poommyroboticcamera-netizen/ESC-FOC-Drive-V02/hardware/CURRENT_SENSE_ERRATUM_TH.md

# ข้อแก้ไขวงจรวัดกระแส ESC V02: C39 / C42 / C45

**สถานะ: พบความเสี่ยงในฮาร์ดแวร์จริง; ยังไม่ได้ยืนยันผลหลังแก้บอร์ด**

ใน [schematic วันที่ 2026-09-22 หน้า 4](SCH_drive_2026-09-22.pdf) C39, C42 และ C45 ต่อ **100 nF โดยตรง** จากขา OUT ของ INA181A1 U13/U14/U15 ลง AGND ตามลำดับ [BOM](BOM_BLDCv02.xlsx) ก็ระบุทั้งสามตัวเป็น 100 nF และผู้ใช้ยืนยันว่าบอร์ดที่ทดสอบใส่ครบ TI ระบุใน [INA181 datasheet หัวข้อ Electrical Characteristics](https://www.ti.com/lit/ds/symlink/ina181.pdf) ว่า capacitive load สูงสุดสำหรับเงื่อนไข “no sustained oscillation” คือ **1 nF** การต่อ 100 nF จึงเกินสเปกนี้ 100 เท่าและเป็นสาเหตุที่เป็นไปได้สูงของการสั่นที่เอาต์พุตเซนเซอร์

หลักฐานจาก `CZERO` บนบอร์ดนี้: trimmed spread ของ U/V/W เท่ากับ **1011 / 925 / 1057 ADC counts** ใน 64 scans ขณะมอเตอร์หยุด เทียบกับเกณฑ์ 48 counts ของเฟิร์มแวร์ v34 โปรแกรมปฏิเสธการสอบศูนย์ถูกต้องแล้ว ข้อมูลนี้ยังไม่พิสูจน์ด้วยออสซิลโลสโคปว่าขา OUT สั่น จึงต้องทดสอบหลังแก้ฮาร์ดแวร์

## แก้บนบอร์ดที่ประกอบแล้ว

1. หยุดมอเตอร์ ตัด VSUPPLY, USB และ ST-LINK รอและ **วัดให้แน่ใจ** ว่าคาปาซิเตอร์ภาคกำลังคายประจุแล้ว ก่อนแตะ PCB
2. ถอด **C39, C42, C45** ออกจากบอร์ดและปล่อยตำแหน่งนี้ว่างเพื่อทดสอบ อย่าถอด C38/C41/C44 ซึ่งเป็น bypass ที่ขา VS ของ INA181 และอย่าสับสนกับ C37/C40/C43 ที่คร่อมชันต์
3. ตรวจด้วยแว่นขยายว่า pad ทั้งสองของแต่ละตำแหน่งไม่ช็อตและลาย CURRENT_U/V/W ไม่เสียหาย [PCB drawing](PCB_V02_2026-09-22.pdf) ระบุ C39 อยู่ข้าง U13, C42 ข้าง U14, C45 ข้าง U15
4. ต่อไฟเลี้ยงแบบจำกัดกระแสตามบอร์ดโดย **ยังไม่ต่อมอเตอร์** ตรวจว่าราง 3.3 V และ REF ของทั้งสามแอมป์อยู่ใกล้ 1.65 V จากนั้นสั่ง `CSCAN ON` และ `CZERO` อีกครั้ง
5. คาดว่าเอาต์พุตที่ไม่มีกระแสจะอยู่ใกล้ REF (ประมาณ 2048 ADC counts ถ้า VDDA=3.3 V) และ `CZERO` ต้องตอบ `OK CZERO state=READY` หากยังไม่ผ่าน ให้จับรูปคลื่น OUT/REF/3.3 V ทีละช่องด้วยโพรบที่อ้าง AGND และตรวจการเดินสาย/ไฟเลี้ยง/ค่า ADC ก่อนขับมอเตอร์ อย่าขยายเกณฑ์ 48 counts เพื่อให้ผ่าน

การถอดคาปาซิเตอร์เป็น **การวินิจฉัยและแก้ภาระโหลดที่เกินสเปก** ไม่ได้ยืนยันว่าการวัดกระแสระหว่าง PWM ถูกต้อง หลัง zero ผ่าน ยังต้องตรวจรูปคลื่น OUT ที่ PWM, จุดเวลาสุ่มตัวอย่าง, polarity และเทียบแอมป์กับกระแสอ้างอิงก่อนใช้งานจริง หากต้องการกรองความถี่สูงใน PCB revision ถัดไป ให้ออกแบบ filter ที่มีการแยกโหลด capacitive จากขา OUT แล้วตรวจเสถียรภาพตาม datasheet; อย่าคัดลอก 100 nF ต่อ OUT โดยตรง
