poommyroboticcamera-netizen/ESC-FOC-Drive-V02/hardware/BOM_BLDCv02.xlsx

No. | Quantity | Comment | Designator | Footprint | Value | Manufacturer Part
1 | 3 | 2.2uF | C18,C19,C20 | C0805 | 2.2uF | CL21A225KBQNNNE
2 | 6 | 22nF | C25,C26,C27,C28,C29,C30 | C1206 | 22nF | HHV1206R7223K631NSPJ
3 | 6 | 10uF | C31,C32,C33,C34,C35,C36 | C0805 | 10uF | GRM21BR61H106KE43L
4 | 12 | 100nF | C37,C38,C39,C40,C41,C42,C43,C44,C45,C58,C82,C83 | C0805 | 100nF | C0805X104K5RAC3123
5 | 4 | 1uF | C46,C47,C48,C50 | C0805 | 1uF | FS21X105K160ECG
6 | 1 | 2.2uF | C49 | C0805 | 2.2uF | FS21X105K160ECG
7 | 2 | 100nF | C59,C61 | C1206 | 100nF | CL31B104KBCNNNC
8 | 3 | 2.2uF | C60,C62,C76 | C1206 | 2.2uF | CL31B225KBHNNNE
9 | 2 | 4.7uF | C64,C66 | C0805 | 4.7uF | CL21A475KAQNNNE
10 | 2 | 22nF | C65,C68 | C0805 | 22nF | CL21B223KBANNNC
11 | 1 | 1uF | C72 | C0805 | 1uF | CL21B105KBFNNNE
12 | 3 | 22uF | C73,C74,C75 | C0805 | 22uF | CL21A226MAQNNNE
13 | 2 | 18pF | C77,C78 | C0603 | 18pF | C1608NP0180JGTS
14 | 2 | 2.2uF | C79,C80 | C0805 | 2.2uF | CL21B225KOFNNNE
15 | 1 | 10nF | C81 | C0805 | 10nF | C2012X7R2E103K125AA
16 | 3 | FR107 | D4,D5,D6 | SMA_L4.2-W2.7-LS5.3-FD |  | FR107
17 | 1 | SS510B | D7 | SMB_L4.3-W3.6-LS5.3-RD |  | SS510B
18 | 1 | SMF12A | D8 | SOD-123_L2.8-W1.8-LS3.7-RD |  | SMF12A
19 | 1 | SMF5.0A | D10 | SOD-123_L2.8-W1.8-LS3.7-RD |  | SMF5.0A
20 | 1 | SMF3.3A | D11 | SOD-123_L2.8-W1.8-LS3.7-RD |  | SMF3.3A
21 | 1 | XY-PZ2.54V-01-10P | H2 | HDR-TH_10P-P2.54-V-M_4 |  | XY-PZ2.54V-01-10P
22 | 2 | 2.54-1*3P | H3,H4 | HDR-TH_3P-P2.54-V-M-1 |  | 2.54-1*3P
23 | 1 | 68uH | L2 | IND-SMD_L7.8-W7.0_SCD0705N | 68uH | SM7850-680M(f)
24 | 1 | KT-0805Y | LED1 | LED0805-R-RD |  | KT-0805Y
25 | 6 | IRFS7530TRL7PP | Q1,Q2,Q3,Q4,Q5,Q6 | D2PAK-7_L10.6-W9.6-P1.27-LS15.9-BR |  | IRFS7530TRL7PP
26 | 3 | EG3112D | R20,R39,R40 | SOP-8_L5.0-W3.9-P1.27-LS6.0-BL-1 |  | EG3112D
27 | 3 | 56K | R32,R59,R60 | R0805_NEW | 56K | RK73H1JTTD10R0F
28 | 6 | 10Ω | R41,R42,R43,R44,R45,R46 | R0603 | 10Ω | WF06P10R0FTL
29 | 3 | 1mΩ | R47,R50,R53 | R2512 | 1mΩ | HIXD25LR001F
30 | 6 | 1kΩ | R48,R49,R51,R52,R54,R55 | R0805 | 1kΩ | AS05W3J0102T5E
31 | 3 | 2.2kΩ | R56,R57,R58 | R0805 | 2.2kΩ | RK73B2ATTD222J
32 | 5 | 10kΩ | R61,R85,R86,R88,R89 | R0805 | 10kΩ | AS05W3J0102T5E
33 | 1 | 30kΩ | R63 | R0603 | 30kΩ | RMC060330K5%N
34 | 1 | 274kΩ | R64 | R0805 | 274kΩ | WR08X2743FTL
35 | 4 | 10kΩ | R65,R66,R69,R70 | R0603 | 10kΩ | KTR03EZPJ103
36 | 1 | 45.3kΩ | R71 | R0603 | 45.3kΩ | WR06X4532FTL
37 | 1 | 5.1kΩ | R72 | R1206 | 5.1kΩ | RK73B2BTTD512J
38 | 9 | 0Ω | R73,R74,R75,R76,R77,R78,R79,R80,R81 | R1206 | 0Ω | 1206W4F0000T5E
39 | 1 | 4.3kΩ | R82 | R0603 | 4.3kΩ | RTT034301FTP
40 | 1 | 73.2kΩ | R83 | R0603 | 73.2kΩ | TD03G7322BT
41 | 1 | 120Ω | R84 | R0805 | 120Ω | CRGCQ0805F120R
42 | 2 | 1kΩ | R87,R90 | R0805 | 1kΩ | TP0805B1K00P0510Z
43 | 4 | TS-1088-AR02016 | SW1,SW2,SW3,SW4 | SW-SMD_L3.9-W3.0-P4.45 |  | TS-1088-AR02016
44 | 2 | 1935174 | U12,U20 | CONN-TH_3P-P5.00_1935174 |  | 1935174
45 | 3 | INA181A1IDBVR | U13,U14,U15 | SOT-23-6_L2.9-W1.6-P0.95-LS2.8-TL |  | INA181A1IDBVR
46 | 1 | STM32F405RGT6 | U18 | LQFP-64_L10.0-W10.0-P0.50-LS12.0-BL |  | STM32F405RGT6
47 | 3 | xh2.54-4p | U19,U27,U28 | CONN-TH_4P-P2.50-XH2.54-4P |  | xh2.54-4p
48 | 1 | SCT2A23STER | U21 | ESOP-8_L4.9-W3.9-P1.27-LS6.0-BL-EP-1 |  | SCT2A23STER
49 | 1 | 68pF | U22 | C0805 | 68pF | HGC0805G0680J500NTGJ
50 | 2 | RY8120 | U23,U25 | SOT-23-6_L2.9-W1.6-P0.95-LS2.8-BL |  | RY8120
51 | 2 | 2.2uH | U24,U26 | IND-SMD_L2.5-W2.0-VLS252012CX-150M |  | 2.2uH
52 | 1 | MCP2551-I/SN | U29 | SOIC-8_L4.9-W3.9-P1.27-LS6.0-BL |  | MCP2551-I/SN
53 | 1 | 8MHz | X4 | CRYSTAL-SMD_4P-L3.2-W2.5-BL | 8MHz | X32258MOB4SI
