poommyroboticcamera-netizen/ESC-FOC-Drive-V02/vesc_firmware_custom/CALIBRATION_2026-09-07_TH.md

# ผลตั้งศูนย์กระแส INA181 วันที่ 7 กันยายน 2026

คาลิเบรตด้วยวงจรที่ผู้ใช้ต่ออยู่ โดยรีเซ็ต MCU ให้ firmware v5 เรียก `do_dc_cal()` ใหม่ ขณะบอร์ด DISARMED ผู้ใช้ยืนยันในบริบทการทดสอบว่าถอดมอเตอร์และปิด PWM อยู่ ไม่มีการส่งคำสั่ง ARM หรือขับมอเตอร์ในรอบนี้ และไม่ได้แฟลชเฟิร์มแวร์ใหม่

## หลักฐานเฟิร์มแวร์และค่า offset

- บอร์ด USB COM7, MCU device ID 0x413; ST-LINK รายงานแรงดันเป้าหมาย 3.25 V
- อ่าน flash กลับและเทียบกับ `bldc_lite_24_sensorless_sixstep_v5_no_startup_boost_raw_oc_2026-09-03.bin`: พื้นที่ 0x08000000–0x08003FFF และ 0x0800C000–0x0807FFEF ตรงกันทุกไบต์ โดยไม่รวม EEPROM และ CRC ที่เปลี่ยนระหว่างทำงาน
- คาลิเบรตเดิมของ v5 รอ 1 วินาที แล้วเฉลี่ยอย่างน้อย 4,000 ตัวอย่างแยกเฟส
- อ่านค่าจริงใน RAM ผ่าน ST-LINK Hot Plug โดยใช้อ้างอิง symbol จาก ELF v5 ที่ตรงกับโค้ดบนบอร์ด

| เฟส | Offset ก่อน (ADC counts) | Offset หลัง (ADC counts) |
|---|---:|---:|
| U | 2052 | 2050 |
| V | 2052 | 2049 |
| W | 2046 | 2043 |

หลังรีเซ็ต `dccal_done = 1`, `software_armed = 0` และ USB รายงาน `Current DC calibration: DONE`, `Software interlock: DISARMED`

## ผลตรวจหลังหัก offset

ใช้ `tools/measure_bldc_zero_usb.ps1` เก็บ COMM_SAMPLE_PRINT / DEBUG_SAMPLING_NOW แบบ raw 3 รอบ รอบละ 512 ตัวอย่าง decimation 20 รวม 1,536 ตัวอย่างต่อเฟส ตรวจ CRC และจำนวน sample index ครบทุกรอบ ข้อมูลนี้มาจาก `ADC_curr_raw` หลังหัก offset ในเส้นทาง BLDC ไม่ใช่ค่า JDR ที่ยังไม่ผ่านตัวกรอง median

ใช้สเกลตาม v5: `(3.3 / 4095) / (0.001 × 20) = 0.040293 A/count` เครื่องหมายในตารางเป็นเครื่องหมาย ADC หลังหัก offset ก่อนเลือกเครื่องหมายของกระแสรวม BLDC

| เฟส | ค่าเฉลี่ย (A) | ค่าต่ำสุด (A) | ค่าสูงสุด (A) | ส่วนเบี่ยงเบนมาตรฐาน (A) |
|---|---:|---:|---:|---:|
| U | -0.03345 | -0.68498 | +0.76557 | 0.12437 |
| V | -0.01495 | -0.64469 | +0.80586 | 0.12592 |
| W | -0.02809 | -0.56410 | +0.84615 | 0.12184 |

ค่าเฉลี่ยอยู่ห่างศูนย์ไม่เกิน 1 ADC count ทุกเฟส แต่ยังพบความแกว่งประมาณ 1.41–1.45 A peak-to-peak ในหน้าต่างที่เก็บมา การตั้งศูนย์จึงเสร็จแล้ว แต่ผลนี้ยังไม่ยืนยันความพร้อมควบคุมกระแส 0.05 A หรือแก้ ABS_OVER_CURRENT ขณะขับมอเตอร์

ค่า offset อยู่ใน RAM และเฟิร์มแวร์จะคาลิเบรตใหม่เมื่อบูต ไม่ใช่การสอบเทียบ gain ด้วยแหล่งกระแสอ้างอิง ค่าบัส 24 V เป็น nominal/estimate ของเฟิร์มแวร์ ไม่ใช่หลักฐานการวัดแรงดันแหล่งจ่ายจริง

ขั้นวิเคราะห์ต่อไปคือวัด OUT, REF และไฟเลี้ยงเทียบกับกราวด์ที่เกี่ยวข้อง ขณะอยู่เงื่อนไขเดียวกับการเก็บ ADC เพื่อแยก noise อนาล็อกออกจากผลของการเก็บตัวอย่าง/กราวด์ สถานะสุดท้ายคง DISARMED และขีดจำกัด fault เดิม
