poommyroboticcamera-netizen/ESC-FOC-Drive-V02/vesc_firmware_custom/tests/overvoltage_fault/overvoltage_test_v2.pdf

Over Voltage Protection Test | Test Results
PSU Normal (Old) | PSU Worst (Old) | PSU Normal (New) | PSU Worst (New)
25.93 V | 32.66 V | 25.43 V | 26.55 V
25.84 V | 32.99 V | 25.44 V | 26.82 V
25.85 V | 33.25 V | 25.64 V | 26.94 V
25.91 V | 33.34 V | 25.46 V | 27.13 V
25.84 V | 33.19 V | 25.72 V | 26.73 V
26.00 V | 33.23 V | 25.63 V | 26.70 V

Test Conditions
Hardware | VESC 6 MK5
Motor | Trampa 160 KV Outrunner
PSU Voltage | 20 V
Max voltage limit | 25 V
Motor Current | 60 A
FOC PI Time Constant | 200 µS

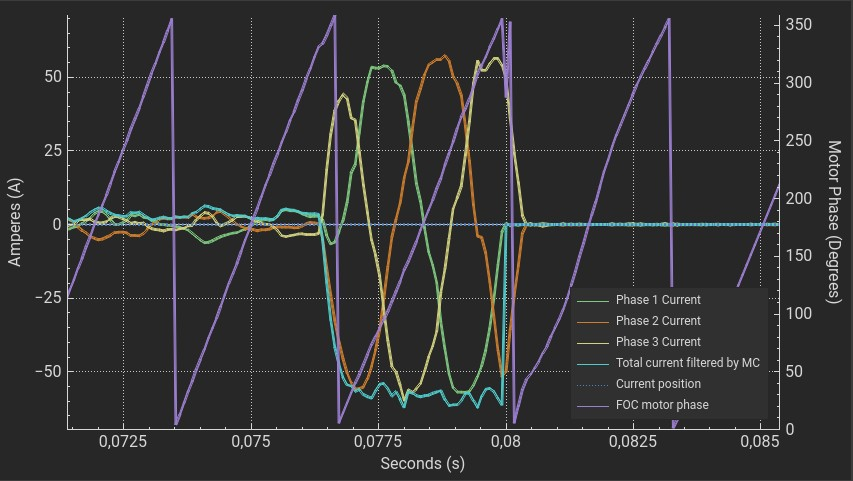
[picture p7: figure]
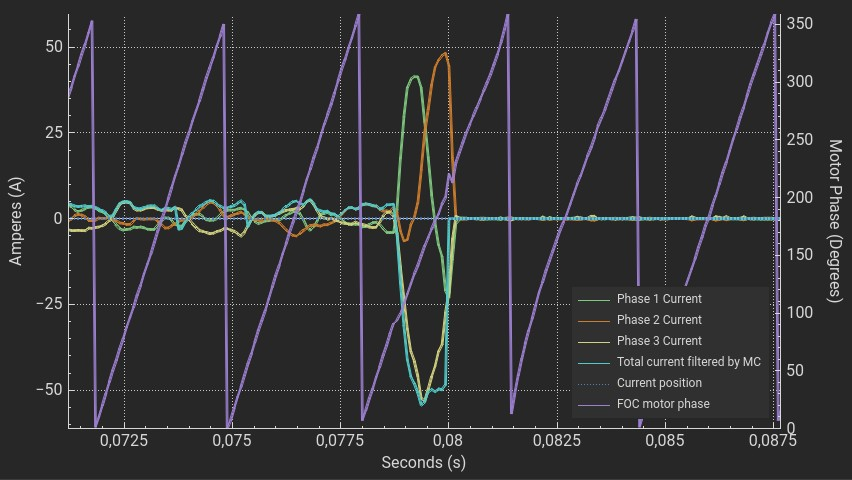
[picture p8: figure]

Old Current plot on normal PSU | Old Current plot on worst PSU

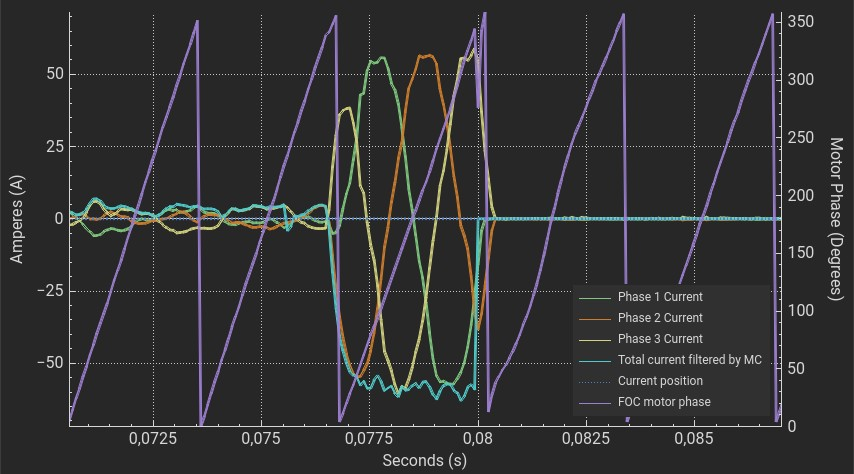
[picture p9: figure]
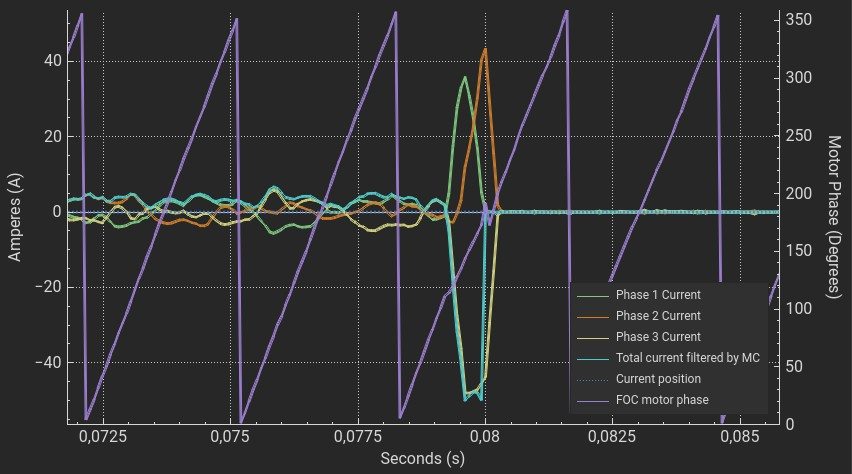
[picture p10: figure]

New Current plot on normal PSU | New Current plot on worst PSU

Run motor at full speed and apply full reverse (that ramps the current faster than full brake). The current controller time constant is set very low so that the current rises fast. Print faults in terminal and write down at which voltage they triggered. PSU normal is a 30V 30A PSU and PSU worst is a 30V 5A PSU that sinks almost no current, so we mostly rely on the capacitance in the VESC to prevent the voltage from rising too much.

Old is the 8-cycle implementation and new is the improved one. The new implementation is also tested on a VESC 6 with a fully charged 12S battery on a scooter to make sure that is doesn’t trigger too easily.
