poommyroboticcamera-netizen/ESC-FOC-Drive-V02/arduino_sixstep_releases/RELEASE_NOTES_current_v1.md

# Arduino six-step current v1

ไฟล์ใน Release นี้สำหรับ STM32F405RGT6:

- `stm32f405-sixstep-current-v1.zip` — ซอร์สโค้ด
- `stm32f405-sixstep-current-v1.elf` — ELF พร้อมแฟลชผ่าน ST-LINK/SWD

SHA-256: `41c9ef685e92431f3b0fc208826f3bf9d339aa6511d98fcc7d4af30b0b86b997`

ELF SHA-256: `28bdb8773c9fb3394c69be11bac83fe93891aadef9d08aa79ec0d24f5e562b32`

รุ่น bring-up ผ่าน Serial Monitor ใช้ INA181 บน PC0/PC1/PC2, zero calibration และ software current trip **ไม่รองรับ SAT motor pilot** และ software trip ไม่ทดแทนวงจร hardware over-current shutdown

วิธีแฟลชและใช้งาน: [คู่มือ Arduino six-step](https://github.com/poommyroboticcamera-netizen/ESC-FOC-Drive-V02/blob/main/arduino_sixstep_releases/README_TH.md)

วิธีแฟลช ELF: [คู่มือ ST-LINK/SWD](https://github.com/poommyroboticcamera-netizen/ESC-FOC-Drive-V02/blob/main/arduino_sixstep_releases/ELF_FLASH_GUIDE_TH.md) สร้างด้วย STM32duino 3.0.0; Verify ผ่าน แต่ยังไม่ได้ทดสอบกับบอร์ดจริง

> ค่ากระแสต้องสอบเทียบกับวงจรจริงก่อนเชื่อผล รุ่นนี้ยังไม่ผ่านการรับรองกับภาคกำลังจริง ใช้แหล่งจ่ายจำกัดกระแส ฟิวส์ และสวิตช์ตัด DC bus
