poommyroboticcamera-netizen/ESC-FOC-Drive-V02/hardware/SCH_drive_2026-09-22.pdf

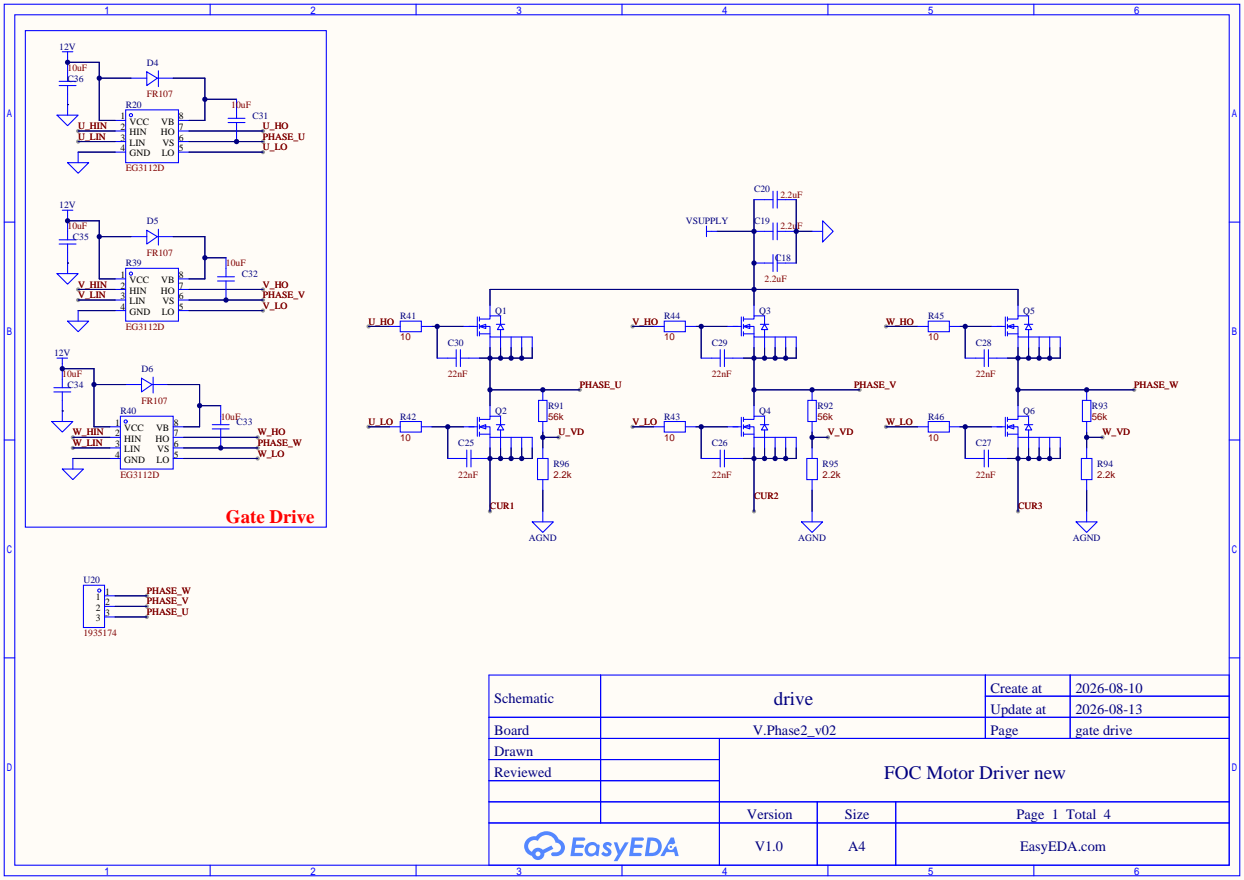
[picture p58: page 1]

Schematic | drive | Create at | 2026-08-10

Update at | 2026-08-13

Board | V.Phase2_v02 | Page | gate drive
Drawn | | FOC Motor Driver new
Reviewed

Version | Size | Page 1 Total 4

V1.0 | A4 | EasyEDA.com

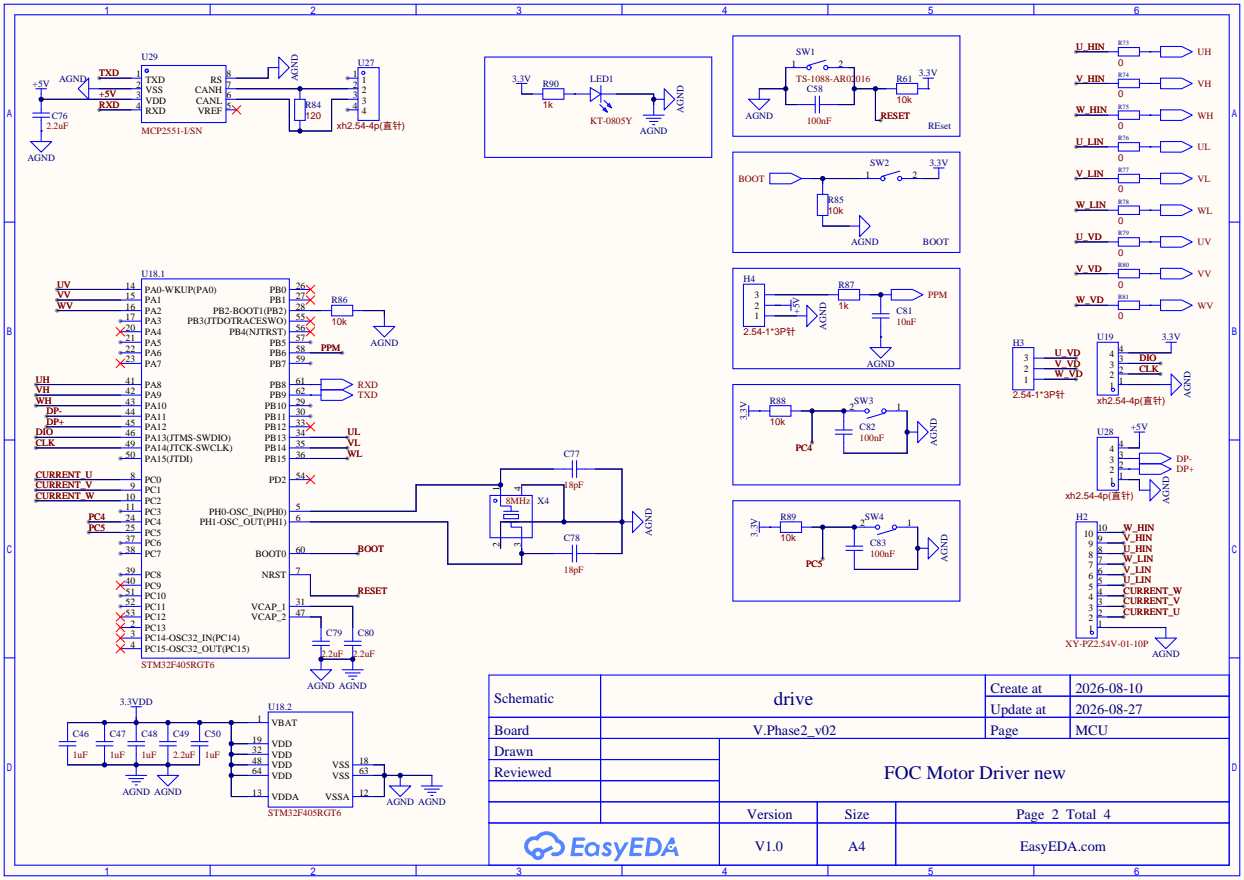
[picture p59: page 2]

Schematic | drive | Create at | 2026-08-10

Update at | 2026-08-27

Board | V.Phase2_v02 | Page | MCU
Drawn | | FOC Motor Driver new
Reviewed

VDD 19

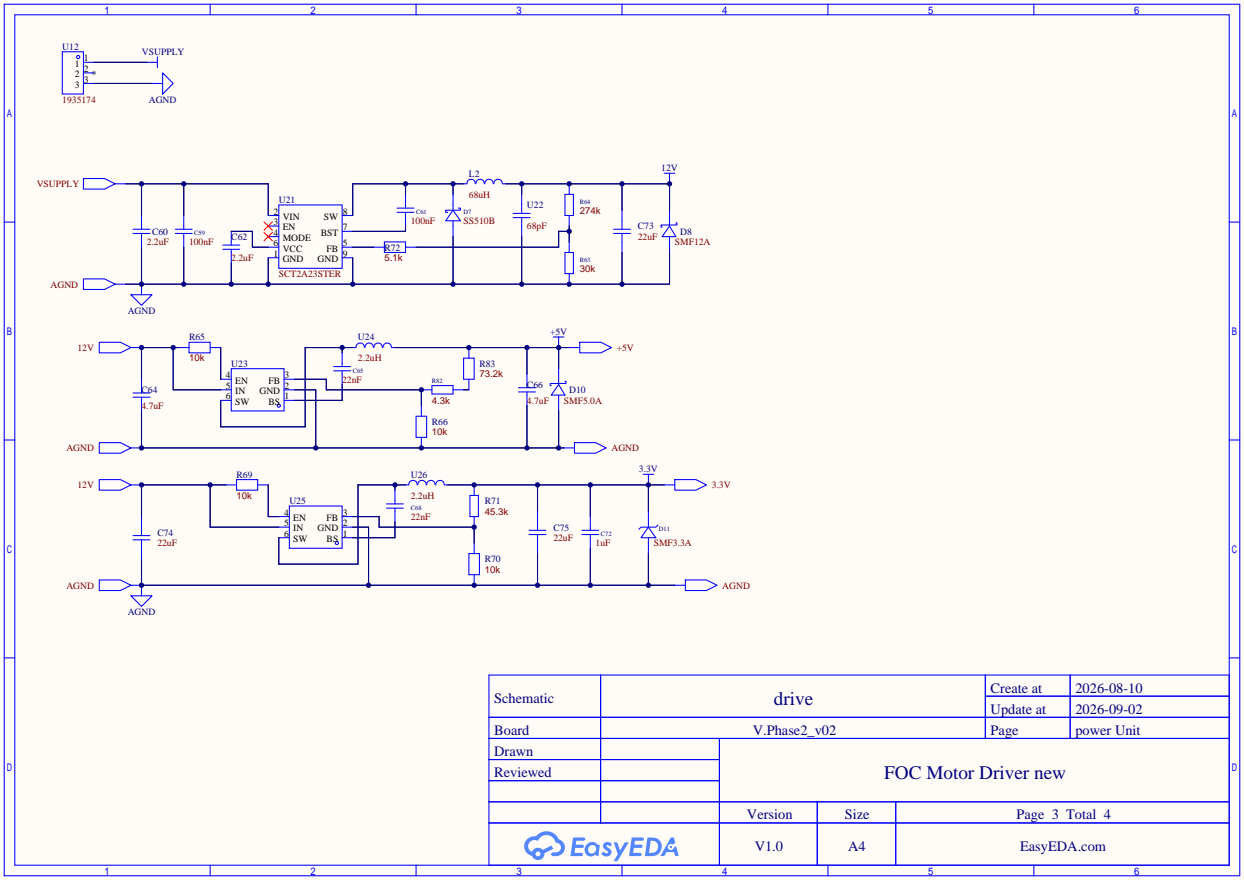
[picture p60: page 3]

Schematic | drive | Create at | 2026-08-10

Update at | 2026-09-02

Board | V.Phase2_v02 | Page | power Unit
Drawn | | FOC Motor Driver new
Reviewed

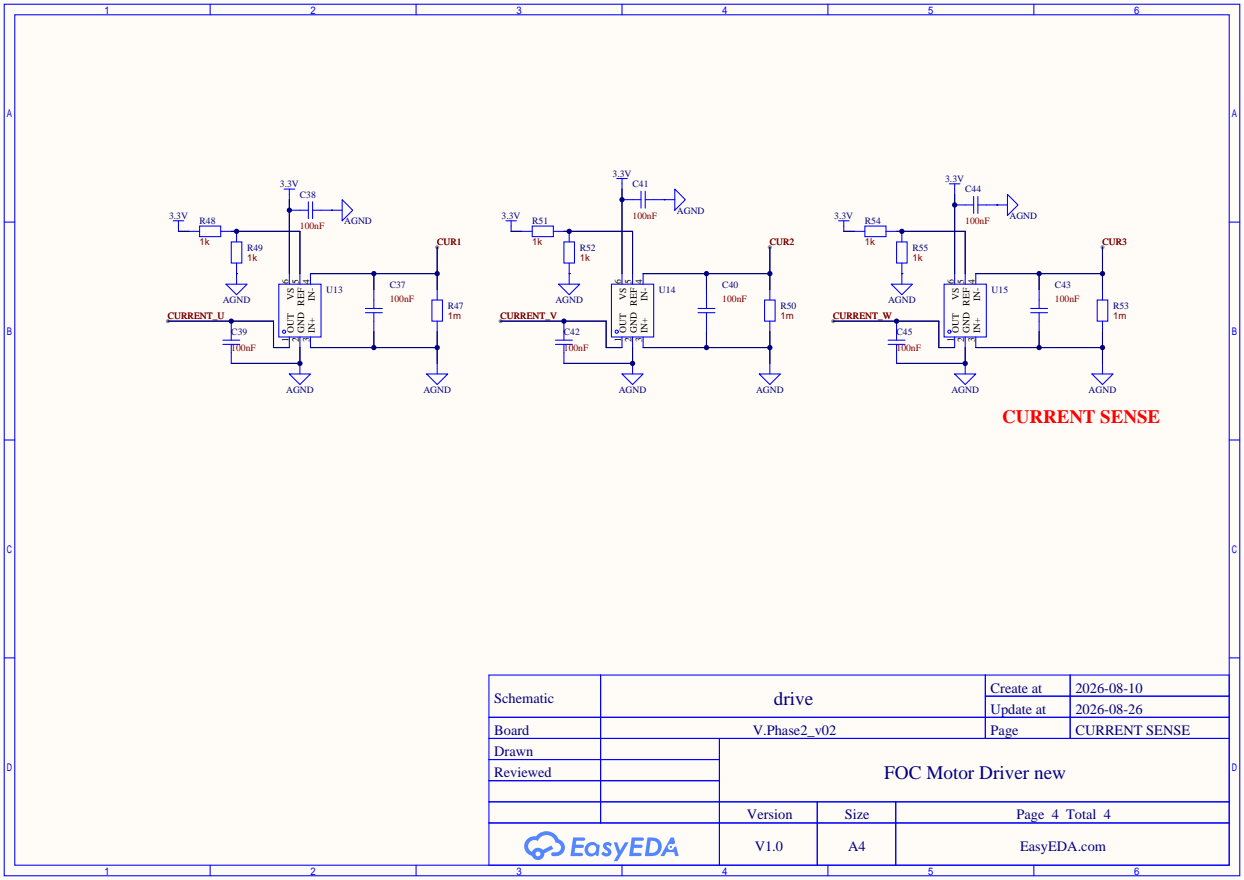
[picture p61: page 4]

Schematic | drive | Create at | 2026-08-10

Update at | 2026-08-26

Board | V.Phase2_v02 | Page | CURRENT SENSE
Drawn | | FOC Motor Driver new
Reviewed
