poommyroboticcamera-netizen/ESC-FOC-Drive-V02/hardware/SCH_v2_2026-08-01.pdf

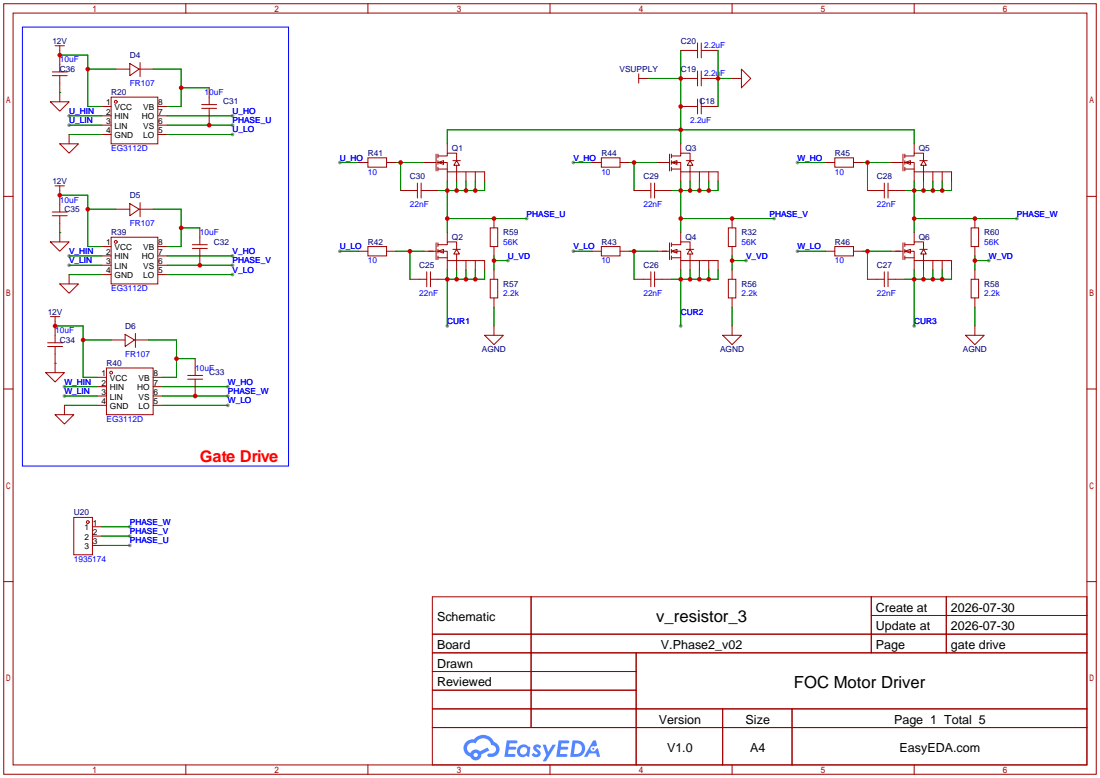
[picture p62: page 1]

Schematic | v_resistor_3 | Create at | 2026-07-30

Update at | 2026-07-30

Board | V.Phase2_v02 | Page | gate drive
Drawn | | FOC Motor Driver
Reviewed

Version | Size | Page 1 Total 5
V1.0 | A4 | EasyEDA.com

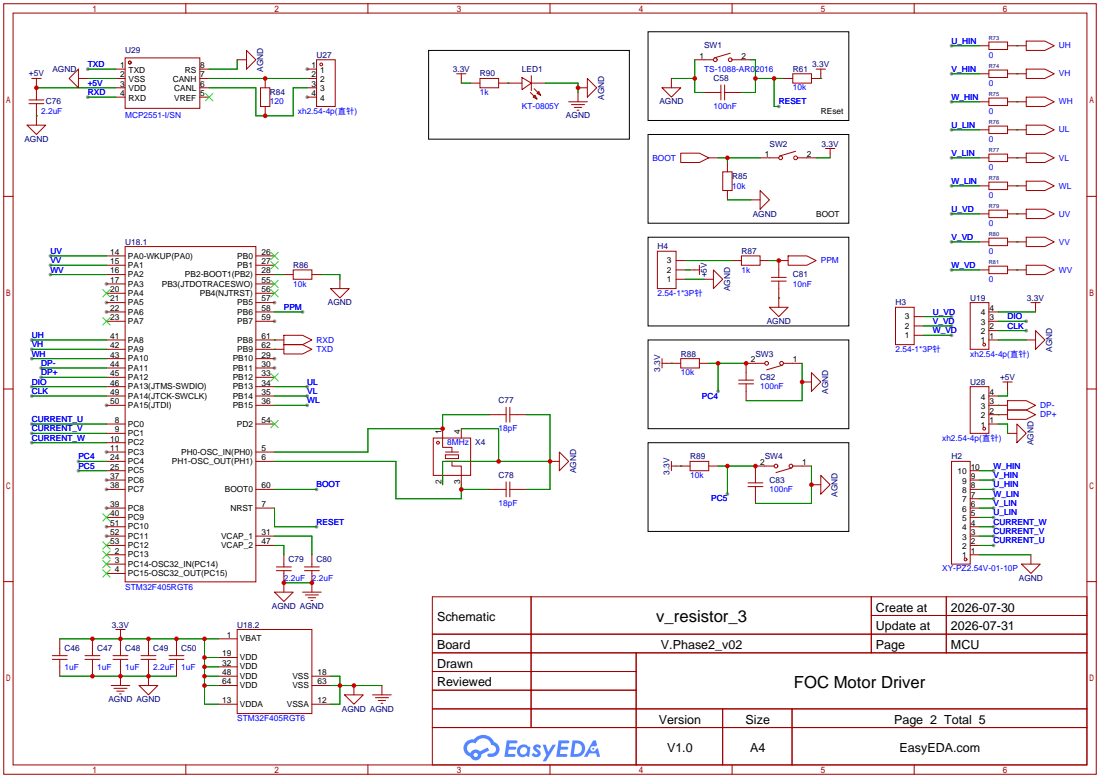
[picture p63: page 2]

Schematic | v_resistor_3 | Create at | 2026-07-30

Update at | 2026-07-31

Board | V.Phase2_v02 | Page | MCU
Drawn | | FOC Motor Driver
Reviewed

VDD 19

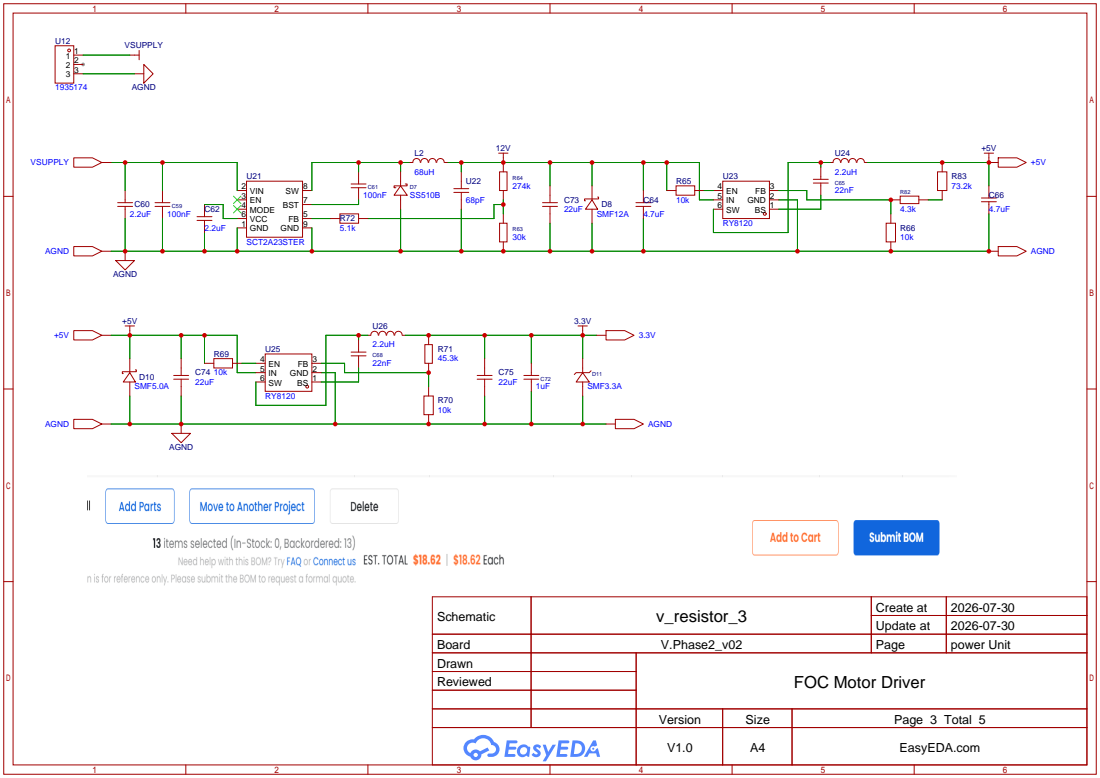
[picture p64: page 3]

Schematic | v_resistor_3 | Create at | 2026-07-30

Update at | 2026-07-30

Board | V.Phase2_v02 | Page | power Unit
Drawn | | FOC Motor Driver
Reviewed

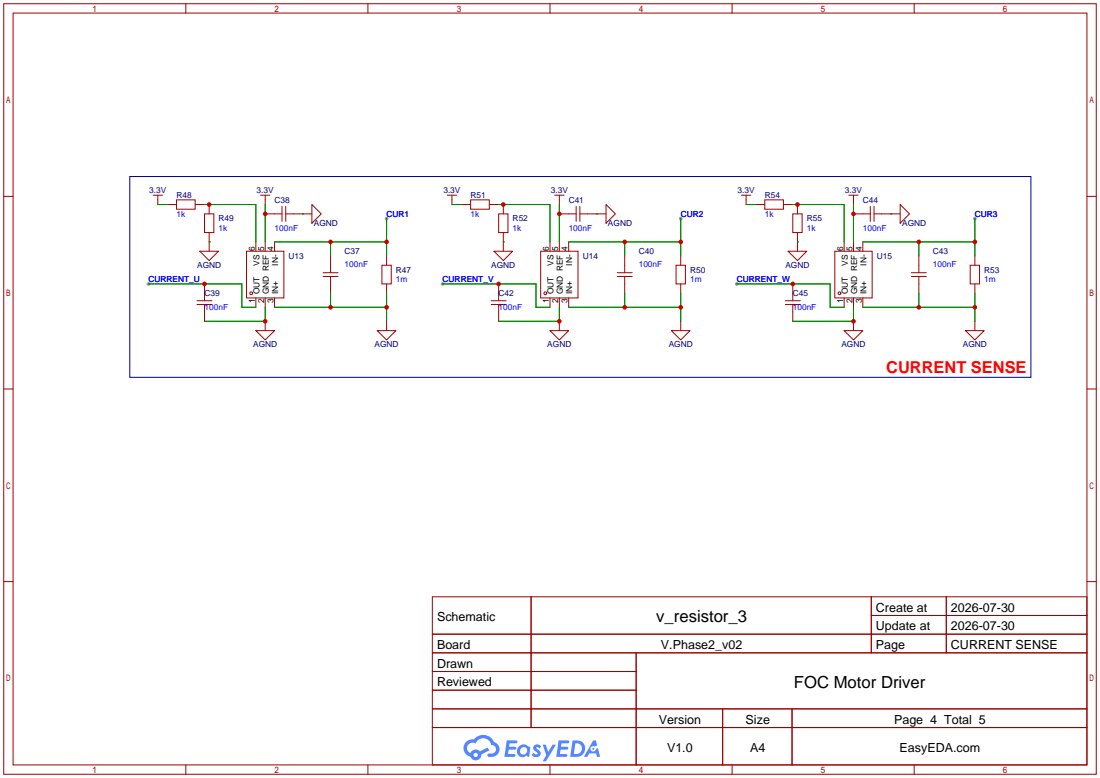
[picture p65: page 4]

Schematic | v_resistor_3 | Create at | 2026-07-30

Update at | 2026-07-30

Board | V.Phase2_v02 | Page | CURRENT SENSE
Drawn | | FOC Motor Driver
Reviewed

# RLC

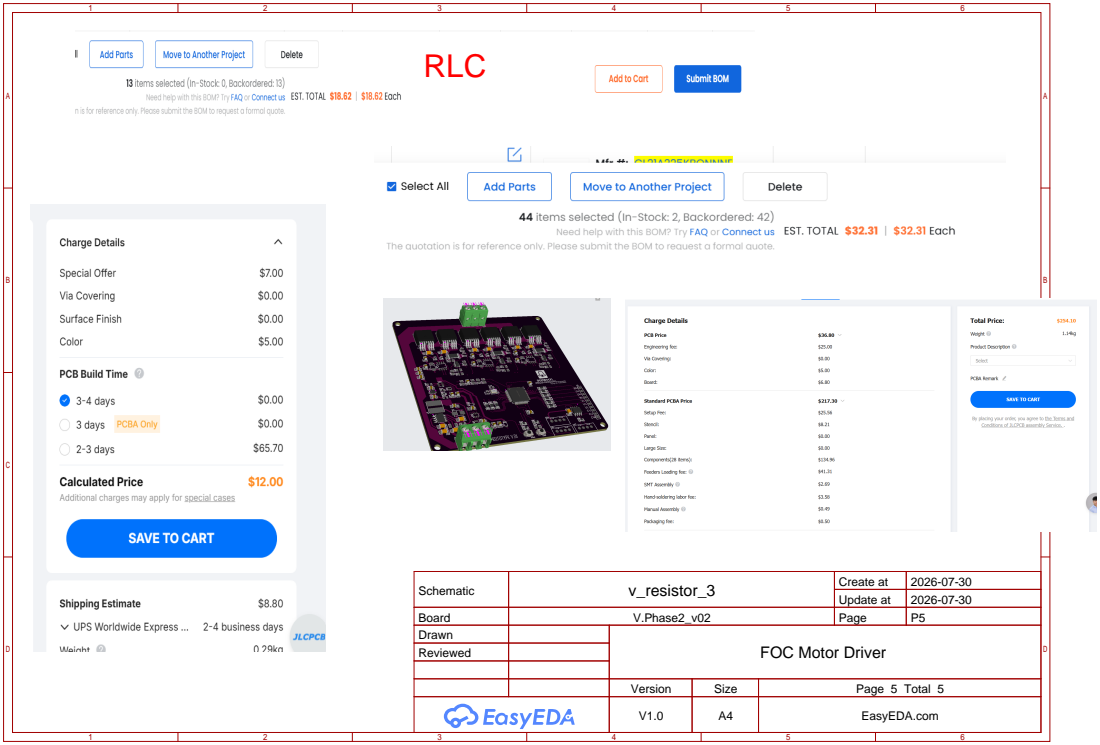
[picture p66: page 5]

Schematic | v_resistor_3 | Create at | 2026-07-30

Update at | 2026-07-30

Board | V.Phase2_v02 | Page | P5
Drawn | | FOC Motor Driver
Reviewed
