poommyroboticcamera-netizen/ESC-FOC-Drive-V02/vesc_firmware_custom/hwconf/shaman/Little_FOCer_4/hw_Little_FOCer_V4.h

/*
	Copyright 2016 Benjamin Vedder	benjamin@vedder.se

	This file is part of the VESC firmware.

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
    You should have received a copy of the GNU General Public License
    along with this program.  If not, see <http://www.gnu.org/licenses/>.
    */

#ifndef HW_LITTLE_FOCER_v4_H_
#define HW_LITTLE_FOCER_v4_H_



  #define HW_NAME                 "Little_FOCer_V4"


// HW properties


#define HW_HAS_3_SHUNTS


// HW properties

#define HW_HAS_PHASE_FILTERS
#define PHASE_FILTER_GPIO       GPIOC
#define PHASE_FILTER_PIN        13
#define PHASE_FILTER_ON()       palSetPad(PHASE_FILTER_GPIO, PHASE_FILTER_PIN)
#define PHASE_FILTER_OFF()      palClearPad(PHASE_FILTER_GPIO, PHASE_FILTER_PIN)
#define HW_DEAD_TIME_NSEC       600.0

// Macros
#define LED_GREEN_ON()          palSetPad(GPIOB, 0)
#define LED_GREEN_OFF()         palClearPad(GPIOB, 0)
#define LED_RED_ON()            palSetPad(GPIOB, 1)
#define LED_RED_OFF()           palClearPad(GPIOB, 1)

#define HW_SHUTDOWN_GPIO		GPIOC
#define HW_SHUTDOWN_PIN			5
#define HW_SHUTDOWN_SENSE_GPIO	GPIOC
#define HW_SHUTDOWN_SENSE_PIN	12
#define HW_SHUTDOWN_HOLD_ON()	palSetPad(HW_SHUTDOWN_GPIO, HW_SHUTDOWN_PIN)
#define HW_SHUTDOWN_HOLD_OFF()	palClearPad(HW_SHUTDOWN_GPIO, HW_SHUTDOWN_PIN)
#define HW_SAMPLE_SHUTDOWN()	hw_sample_shutdown_button()

/*
 * ADC Vector
 *
 * 0:   IN0     SENS1
 * 1:   IN1     SENS2
 * 2:   IN2     SENS3
 * 3:   IN10    CURR1
 * 4:   IN11    CURR2
 * 5:   IN12    CURR3
 * 6:   IN5     ADC_EXT1
 * 7:   IN6     ADC_EXT2
 * 8:   IN3     TEMP_PCB
 * 9:   IN14    TEMP_MOTOR
 * 10:  IN15    Shutdown
 * 11:  IN13    AN_IN
 * 12:  Vrefint
 * 13:  IN0     SENS1
 * 14:  IN1     SENS2
 */

#define HW_ADC_CHANNELS         15
#define HW_ADC_INJ_CHANNELS     3
#define HW_ADC_NBR_CONV         5

// ADC Indexes
#define ADC_IND_SENS1           0
#define ADC_IND_SENS2           1
#define ADC_IND_SENS3           2
#define ADC_IND_CURR1           3
#define ADC_IND_CURR2           4
#define ADC_IND_CURR3           5
#define ADC_IND_VIN_SENS        11
#define ADC_IND_EXT             6
#define ADC_IND_EXT2            7
#define ADC_IND_TEMP_MOS        8
#define ADC_IND_TEMP_MOTOR      9
#define ADC_IND_VREFINT         12
#define ADC_IND_SHUTDOWN        10

// ADC macros and settings

// Component parameters (can be overridden)
#ifndef V_REG
#define V_REG                   3.3
#endif
#ifndef VIN_R1
#define VIN_R1                  68000.0
#endif
#ifndef VIN_R2
#define VIN_R2                  2200.0
#endif
#ifndef CURRENT_AMP_GAIN
#define CURRENT_AMP_GAIN        20.0
#endif
#ifndef CURRENT_SHUNT_RES
#define CURRENT_SHUNT_RES       0.0002
#endif

// Input voltage
#define GET_INPUT_VOLTAGE()     ((V_REG / 4095.0) * (float)ADC_Value[ADC_IND_VIN_SENS] * ((VIN_R1 + VIN_R2) / VIN_R2))

// NTC Termistors
#define NTC_RES(adc_val)        ((4095.0 * 10000.0) / adc_val - 10000.0)
#define NTC_TEMP(adc_ind)       (1.0 / ((logf(NTC_RES(ADC_Value[adc_ind]) / 10000.0) / 3380.0) + (1.0 / 298.15)) - 273.15)

#define NTC_RES_MOTOR(adc_val)  (10000.0 / ((4095.0 / (float)adc_val) - 1.0)) // Motor temp sensor on low side
#define NTC_TEMP_MOTOR(beta)    (1.0 / ((logf(NTC_RES_MOTOR(ADC_Value[ADC_IND_TEMP_MOTOR]) / 10000.0) / beta) + (1.0 / 298.15)) - 273.15)

// Voltage on ADC channel
#define ADC_VOLTS(ch)           ((float)ADC_Value[ch] / 4096.0 * V_REG)

// Double samples in beginning and end for positive current measurement.
// Useful when the shunt sense traces have noise that causes offset.
#ifndef CURR1_DOUBLE_SAMPLE
#define CURR1_DOUBLE_SAMPLE     0
#endif
#ifndef CURR2_DOUBLE_SAMPLE
#define CURR2_DOUBLE_SAMPLE     0
#endif
#ifndef CURR3_DOUBLE_SAMPLE
#define CURR3_DOUBLE_SAMPLE     0
#endif

// COMM-port ADC GPIOs
#define HW_ADC_EXT_GPIO         GPIOA
#define HW_ADC_EXT_PIN          5
#define HW_ADC_EXT2_GPIO        GPIOA
#define HW_ADC_EXT2_PIN         6

// UART Peripheral
#define HW_UART_DEV             SD3
#define HW_UART_GPIO_AF         GPIO_AF_USART3
#define HW_UART_TX_PORT         GPIOB
#define HW_UART_TX_PIN          10
#define HW_UART_RX_PORT         GPIOB
#define HW_UART_RX_PIN          11

// Permanent UART Peripheral (for NRF51)
#define HW_UART_P_BAUD          115200
#define HW_UART_P_DEV           SD4
#define HW_UART_P_GPIO_AF       GPIO_AF_UART4
#define HW_UART_P_TX_PORT       GPIOC
#define HW_UART_P_TX_PIN        10
#define HW_UART_P_RX_PORT       GPIOC
#define HW_UART_P_RX_PIN        11

// ICU Peripheral for servo decoding
#define HW_USE_SERVO_TIM4
#define HW_ICU_TIMER            TIM4
#define HW_ICU_TIM_CLK_EN()     RCC_APB1PeriphClockCmd(RCC_APB1Periph_TIM4, ENABLE)
#define HW_ICU_DEV              ICUD4
#define HW_ICU_CHANNEL          ICU_CHANNEL_1
#define HW_ICU_GPIO_AF          GPIO_AF_TIM4
#define HW_ICU_GPIO             GPIOB
#define HW_ICU_PIN              6

// I2C Peripheral
#define HW_I2C_DEV              I2CD2
#define HW_I2C_GPIO_AF          GPIO_AF_I2C2
#define HW_I2C_SCL_PORT         GPIOB
#define HW_I2C_SCL_PIN          10
#define HW_I2C_SDA_PORT         GPIOB
#define HW_I2C_SDA_PIN          11

// Hall/encoder pins
#define HW_HALL_ENC_GPIO1       GPIOC
#define HW_HALL_ENC_PIN1        6
#define HW_HALL_ENC_GPIO2       GPIOC
#define HW_HALL_ENC_PIN2        7
#define HW_HALL_ENC_GPIO3       GPIOC
#define HW_HALL_ENC_PIN3        8
#define HW_ENC_TIM              TIM3
#define HW_ENC_TIM_AF           GPIO_AF_TIM3
#define HW_ENC_TIM_CLK_EN()     RCC_APB1PeriphClockCmd(RCC_APB1Periph_TIM3, ENABLE)
#define HW_ENC_EXTI_PORTSRC     EXTI_PortSourceGPIOC
#define HW_ENC_EXTI_PINSRC      EXTI_PinSource8
#define HW_ENC_EXTI_LINE        EXTI_Line8
#define HW_ENC_TIM_ISR_CH       TIM3_IRQn
#define HW_ENC_TIM_ISR_VEC      TIM3_IRQHandler

// SPI pins
#define HW_SPI_DEV              SPID1
#define HW_SPI_GPIO_AF          GPIO_AF_SPI1
#define HW_SPI_PORT_NSS         GPIOA
#define HW_SPI_PIN_NSS          4
#define HW_SPI_PORT_SCK         GPIOA
#define HW_SPI_PIN_SCK          5
#define HW_SPI_PORT_MOSI        GPIOA
#define HW_SPI_PIN_MOSI         7
#define HW_SPI_PORT_MISO        GPIOA
#define HW_SPI_PIN_MISO         6

#ifdef HW_HAS_DRV8323S
// SPI for DRV8323S rev2
#define DRV8323S_MOSI_GPIO       GPIOC
#define DRV8323S_MOSI_PIN        12
#define DRV8323S_MISO_GPIO       GPIOD
#define DRV8323S_MISO_PIN        2
#define DRV8323S_SCK_GPIO        GPIOC
#define DRV8323S_SCK_PIN         13
#define DRV8323S_CS_GPIO         GPIOC
#define DRV8323S_CS_PIN          9
#endif

// IMU:

// LSM6DS3
#define IMU_DEV                 IMU_DEV_LSM6DS3
#define IMU_COM                 IMU_COM_I2C_BB
#define IMU_BUS_SPEED_HZ        700000
#define IMU_I2C_SDA_GPIO        GPIOB
#define IMU_I2C_SDA_PIN         2
#define IMU_I2C_SCL_GPIO        GPIOA
#define IMU_I2C_SCL_PIN         15


// NRF SWD
#define NRF5x_SWDIO_GPIO        GPIOB
#define NRF5x_SWDIO_PIN         4
#define NRF5x_SWCLK_GPIO        GPIOB
#define NRF5x_SWCLK_PIN         3

// Measurement macros
#define ADC_V_L1                ADC_Value[ADC_IND_SENS1]
#define ADC_V_L2                ADC_Value[ADC_IND_SENS2]
#define ADC_V_L3                ADC_Value[ADC_IND_SENS3]
#define ADC_V_ZERO              (ADC_Value[ADC_IND_VIN_SENS] / 2)

// Macros
#define READ_HALL1()            palReadPad(HW_HALL_ENC_GPIO1, HW_HALL_ENC_PIN1)
#define READ_HALL2()            palReadPad(HW_HALL_ENC_GPIO2, HW_HALL_ENC_PIN2)
#define READ_HALL3()            palReadPad(HW_HALL_ENC_GPIO3, HW_HALL_ENC_PIN3)

// Default setting overrides
#ifndef MCCONF_L_MIN_VOLTAGE
#define MCCONF_L_MIN_VOLTAGE            18.0        // Minimum input voltage
#endif
#ifndef MCCONF_L_MAX_VOLTAGE
#define MCCONF_L_MAX_VOLTAGE            95.0    // Maximum input voltage
#endif
#ifndef MCCONF_L_CURRENT_MAX
#ifdef LFOC_IS_V3
#define MCCONF_L_CURRENT_MAX                100.0    // Current limit in Amperes (Upper)
#else
#define MCCONF_L_CURRENT_MAX                70.0    // Current limit in Amperes (Upper)
#endif
#endif
#ifndef MCCONF_L_CURRENT_MIN
#define MCCONF_L_CURRENT_MIN                -50.0   // Current limit in Amperes (Lower)
#endif
#ifndef MCCONF_L_IN_CURRENT_MAX
#define MCCONF_L_IN_CURRENT_MAX             60.0    // Input current limit in Amperes (Upper)
#endif
#ifndef MCCONF_L_IN_CURRENT_MIN
#define MCCONF_L_IN_CURRENT_MIN             -60.0   // Input current limit in Amperes (Lower)
#endif
#ifndef MCCONF_L_MAX_ABS_CURRENT
#ifdef LFOC_IS_V3
#define MCCONF_L_MAX_ABS_CURRENT            300.0   // The maximum absolute current above which a fault is generated
#else
#define MCCONF_L_MAX_ABS_CURRENT            130.0   // The maximum absolute current above which a fault is generated
#endif
#endif
#ifndef MCCONF_L_LIM_TEMP_FET_START
#define MCCONF_L_LIM_TEMP_FET_START     80.0    // MOSFET temperature where current limiting should begin
#endif
#ifndef MCCONF_L_LIM_TEMP_FET_END
#define MCCONF_L_LIM_TEMP_FET_END       100.0   // MOSFET temperature where everything should be shut off
#endif
#ifndef MCCONF_DEFAULT_MOTOR_TYPE
#define MCCONF_DEFAULT_MOTOR_TYPE       MOTOR_TYPE_FOC
#endif
#ifndef MCCONF_FOC_F_ZV
#define MCCONF_FOC_F_ZV                 25000.0
#endif

// Setting limits

#define HW_LIM_CURRENT          -250.0, 250.0
#define HW_LIM_CURRENT_IN       -100.0, 100.0
#define HW_LIM_CURRENT_ABS      0.0, 350.0

#define HW_LIM_VIN              18.0, 95.0
#define HW_LIM_ERPM             -200e3, 200e3
#define HW_LIM_DUTY_MIN         0.0, 0.1
#define HW_LIM_DUTY_MAX         0.0, 0.99
#define HW_LIM_TEMP_FET         -40.0, 110.0

// Functions
bool hw_sample_shutdown_button(void);

#endif /* HW_LITTLE_FOCER_H_ */
