poommyroboticcamera-netizen/ESC-FOC-Drive-V02/vesc_firmware_custom/hwconf/vesc/maxim/hw_maxim_core.c

/*
	Copyright 2018 Benjamin Vedder	benjamin@vedder.se

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
    You should have received a copy of the GNU General Public License
    along with this program.  If not, see <http://www.gnu.org/licenses/>.
    */

#include "hw.h"
#include "ch.h"
#include "hal.h"
#include "stm32f4xx_conf.h"
#include "utils_math.h"
#include <math.h>
#include "mc_interface.h"
#include "lispif.h"
#include "lispbm.h"
#include "terminal.h"
#include "commands.h"

// Variables
static volatile bool i2c_running = false;
static THD_WORKING_AREA(mux_thread_wa, 256);
static THD_FUNCTION(mux_thread, arg);
static volatile bool mux_thd_running = false;

// I2C configuration
static const I2CConfig i2cfg = {
		OPMODE_I2C,
		100000,
		STD_DUTY_CYCLE
};

static lbm_value ext_reg_v(lbm_value *args, lbm_uint argn) {
	(void)args; (void)argn;
	float adc = (float)ADC_Value[ADC_IND_12V_SENSE_V];
	// V-div 22k - 2.2k
	return lbm_enc_float(adc * (V_REG / 4095.0) * ((22.0 + 2.2) / 2.2));
}

static lbm_value ext_reg_i(lbm_value *args, lbm_uint argn) {
	(void)args; (void)argn;
	float adc = (float)ADC_Value[ADC_IND_12V_SENSE_I];
	// 0.01 ohm, shunt amp same as rest of hw
	return lbm_enc_float((adc * (V_REG / 4095.0) - (V_REG / 2.0)) / (CURRENT_AMP_GAIN * 0.01));
}

static lbm_value ext_reg_t(lbm_value *args, lbm_uint argn) {
	(void)args; (void)argn;
	return lbm_enc_float(NTC_TEMP_DCDC());
}

static lbm_value ext_reg5_v(lbm_value *args, lbm_uint argn) {
	(void)args; (void)argn;
	float adc = (float)ADC_Value[ADC_IND_5V_SENSE_V];
	// V-div 10k - 10k
	return lbm_enc_float(adc * (V_REG / 4095.0) * ((10.0 + 10.0) / 10.0));
}

static void load_extensions(bool main_found) {
	if (!main_found) {
		lbm_add_extension("hw-reg-v", ext_reg_v);
		lbm_add_extension("hw-reg-i", ext_reg_i);
		lbm_add_extension("hw-reg-t", ext_reg_t);
		lbm_add_extension("hw-reg5-v", ext_reg5_v);
	}
}

static void terminal_hw_diag(int argc, const char **argv) {
	(void)argc;
	(void)argv;

	for (int i = 0;i < 40;i++) {
		float t1 = (1.0 / ((logf(NTC_RES(ADC_Value[ADC_IND_TEMP_MOS]) / 10000.0) / 3380.0) + (1.0 / 298.15)) - 273.15);
		float t2 = (1.0 / ((logf(NTC_RES(ADC_Value[ADC_IND_TEMP_MOS_2]) / 10000.0) / 3380.0) + (1.0 / 298.15)) - 273.15);
		float t3 = (1.0 / ((logf(NTC_RES(ADC_Value[ADC_IND_TEMP_MOS_3]) / 10000.0) / 3380.0) + (1.0 / 298.15)) - 273.15);

		commands_printf("BT: %.2f", (double)ADC_VOLTS(ADC_IND_SHUTDOWN));
		commands_printf("T1: %.2f", (double)t1);
		commands_printf("T2: %.2f", (double)t2);
		commands_printf("T3: %.2f\n", (double)t3);
		chThdSleepMilliseconds(100);
	}
}

void hw_init_gpio(void) {
	// GPIO clock enable
	RCC_AHB1PeriphClockCmd(RCC_AHB1Periph_GPIOA, ENABLE);
	RCC_AHB1PeriphClockCmd(RCC_AHB1Periph_GPIOB, ENABLE);
	RCC_AHB1PeriphClockCmd(RCC_AHB1Periph_GPIOC, ENABLE);
	RCC_AHB1PeriphClockCmd(RCC_AHB1Periph_GPIOD, ENABLE);

	// LEDs
	palSetPadMode(LED_GREEN_GPIO, LED_GREEN_PIN,
			PAL_MODE_OUTPUT_PUSHPULL |
			PAL_STM32_OSPEED_HIGHEST);
	palSetPadMode(LED_RED_GPIO, LED_RED_PIN,
			PAL_MODE_OUTPUT_PUSHPULL |
			PAL_STM32_OSPEED_HIGHEST);

	// GPIOA Configuration: Channel 1 to 3 as alternate function push-pull
	palSetPadMode(GPIOA, 8, PAL_MODE_ALTERNATE(GPIO_AF_TIM1) |
			PAL_STM32_OSPEED_HIGHEST |
			PAL_STM32_PUDR_FLOATING);
	palSetPadMode(GPIOA, 9, PAL_MODE_ALTERNATE(GPIO_AF_TIM1) |
			PAL_STM32_OSPEED_HIGHEST |
			PAL_STM32_PUDR_FLOATING);
	palSetPadMode(GPIOA, 10, PAL_MODE_ALTERNATE(GPIO_AF_TIM1) |
			PAL_STM32_OSPEED_HIGHEST |
			PAL_STM32_PUDR_FLOATING);

	palSetPadMode(GPIOB, 13, PAL_MODE_ALTERNATE(GPIO_AF_TIM1) |
			PAL_STM32_OSPEED_HIGHEST |
			PAL_STM32_PUDR_FLOATING);
	palSetPadMode(GPIOB, 14, PAL_MODE_ALTERNATE(GPIO_AF_TIM1) |
			PAL_STM32_OSPEED_HIGHEST |
			PAL_STM32_PUDR_FLOATING);
	palSetPadMode(GPIOB, 15, PAL_MODE_ALTERNATE(GPIO_AF_TIM1) |
			PAL_STM32_OSPEED_HIGHEST |
			PAL_STM32_PUDR_FLOATING);

	// Hall sensors
	palSetPadMode(HW_HALL_ENC_GPIO1, HW_HALL_ENC_PIN1, PAL_MODE_INPUT_PULLUP);
	palSetPadMode(HW_HALL_ENC_GPIO2, HW_HALL_ENC_PIN2, PAL_MODE_INPUT_PULLUP);
	palSetPadMode(HW_HALL_ENC_GPIO3, HW_HALL_ENC_PIN3, PAL_MODE_INPUT_PULLUP);

	// Phase filters
	palSetPadMode(PHASE_FILTER_GPIO, PHASE_FILTER_PIN,
			PAL_MODE_OUTPUT_PUSHPULL |
			PAL_STM32_OSPEED_HIGHEST);
	PHASE_FILTER_OFF();

	CURRENT_FILTER_OFF();

	// ADC Pins
	palSetPadMode(GPIOA, 0, PAL_MODE_INPUT_ANALOG);
	palSetPadMode(GPIOA, 1, PAL_MODE_INPUT_ANALOG);
	palSetPadMode(GPIOA, 2, PAL_MODE_INPUT_ANALOG);
	palSetPadMode(GPIOA, 3, PAL_MODE_INPUT_ANALOG);
	palSetPadMode(GPIOA, 5, PAL_MODE_INPUT_ANALOG);
	palSetPadMode(GPIOA, 6, PAL_MODE_INPUT_ANALOG);
	palSetPadMode(GPIOA, 7, PAL_MODE_INPUT_ANALOG);

	palSetPadMode(GPIOB, 0, PAL_MODE_INPUT_ANALOG);
	palSetPadMode(GPIOB, 1, PAL_MODE_INPUT_ANALOG);

	palSetPadMode(GPIOC, 0, PAL_MODE_INPUT_ANALOG);
	palSetPadMode(GPIOC, 1, PAL_MODE_INPUT_ANALOG);
	palSetPadMode(GPIOC, 2, PAL_MODE_INPUT_ANALOG);
	palSetPadMode(GPIOC, 3, PAL_MODE_INPUT_ANALOG);
	palSetPadMode(GPIOC, 4, PAL_MODE_INPUT_ANALOG);

#if defined(HWMAXIM_120_PH) || defined(HWMAXIM_150_PH)
	palSetPadMode(GPIOA, 4, PAL_MODE_INPUT_PULLUP);
#else
	// DAC as voltage reference for shunt amps
	palSetPadMode(GPIOA, 4, PAL_MODE_INPUT_ANALOG);
	RCC_APB1PeriphClockCmd(RCC_APB1Periph_DAC, ENABLE);
	DAC->CR |= DAC_CR_EN1;
	DAC->DHR12R1 = 2047;
#endif

	lispif_add_ext_load_callback(load_extensions);

	terminal_register_command_callback(
				"hw_diag",
				"Print HW diagnostics",
				0,
				terminal_hw_diag);
}

void hw_setup_adc_channels(void) {
	uint8_t sample_time = ADC_SampleTime_15Cycles;

	// ADC1 regular channels
	ADC_RegularChannelConfig(ADC1, ADC_Channel_10, 1, sample_time);			// 0
	ADC_RegularChannelConfig(ADC1, ADC_Channel_0, 2, sample_time);			// 3
	ADC_RegularChannelConfig(ADC1, ADC_Channel_7, 3, sample_time);			// 6
	ADC_RegularChannelConfig(ADC1, ADC_Channel_14, 4, sample_time);			// 9
	ADC_RegularChannelConfig(ADC1, ADC_Channel_14, 5, sample_time);			// 12
	ADC_RegularChannelConfig(ADC1, ADC_Channel_8, 6, sample_time);			// 15

	// ADC2 regular channels
	ADC_RegularChannelConfig(ADC2, ADC_Channel_11, 1, sample_time);			// 1
	ADC_RegularChannelConfig(ADC2, ADC_Channel_1, 2, sample_time);			// 4
	ADC_RegularChannelConfig(ADC2, ADC_Channel_6, 3, sample_time);			// 7
	ADC_RegularChannelConfig(ADC2, ADC_Channel_15, 4, sample_time);			// 10
	ADC_RegularChannelConfig(ADC2, ADC_Channel_5, 5, sample_time);			// 13
	ADC_RegularChannelConfig(ADC2, ADC_Channel_9, 6, sample_time);			// 16

	// ADC3 regular channels
	ADC_RegularChannelConfig(ADC3, ADC_Channel_12, 1, sample_time);			// 2
	ADC_RegularChannelConfig(ADC3, ADC_Channel_2, 2, sample_time);			// 5
	ADC_RegularChannelConfig(ADC3, ADC_Channel_13, 3, sample_time);			// 8
	ADC_RegularChannelConfig(ADC3, ADC_Channel_3, 4, sample_time);			// 11
	ADC_RegularChannelConfig(ADC3, ADC_Channel_3, 5, sample_time);			// 14
	ADC_RegularChannelConfig(ADC3, ADC_Channel_3, 6, sample_time);			// 17

	// Injected channels
	ADC_InjectedChannelConfig(ADC1, ADC_Channel_10, 1, sample_time);
	ADC_InjectedChannelConfig(ADC2, ADC_Channel_11, 1, sample_time);
	ADC_InjectedChannelConfig(ADC3, ADC_Channel_12, 1, sample_time);
	ADC_InjectedChannelConfig(ADC1, ADC_Channel_10, 2, sample_time);
	ADC_InjectedChannelConfig(ADC2, ADC_Channel_11, 2, sample_time);
	ADC_InjectedChannelConfig(ADC3, ADC_Channel_12, 2, sample_time);
	ADC_InjectedChannelConfig(ADC1, ADC_Channel_10, 3, sample_time);
	ADC_InjectedChannelConfig(ADC2, ADC_Channel_11, 3, sample_time);
	ADC_InjectedChannelConfig(ADC3, ADC_Channel_12, 3, sample_time);

	if (!mux_thd_running) {
		chThdCreateStatic(mux_thread_wa, sizeof(mux_thread_wa), NORMALPRIO, mux_thread, NULL);
		mux_thd_running = true;
	}
}

void hw_start_i2c(void) {
	i2cAcquireBus(&HW_I2C_DEV);

	if (!i2c_running) {
		palSetPadMode(HW_I2C_SCL_PORT, HW_I2C_SCL_PIN,
				PAL_MODE_ALTERNATE(HW_I2C_GPIO_AF) |
				PAL_STM32_OTYPE_OPENDRAIN |
				PAL_STM32_OSPEED_MID1 |
				PAL_STM32_PUDR_PULLUP);
		palSetPadMode(HW_I2C_SDA_PORT, HW_I2C_SDA_PIN,
				PAL_MODE_ALTERNATE(HW_I2C_GPIO_AF) |
				PAL_STM32_OTYPE_OPENDRAIN |
				PAL_STM32_OSPEED_MID1 |
				PAL_STM32_PUDR_PULLUP);

		i2cStart(&HW_I2C_DEV, &i2cfg);
		i2c_running = true;
	}

	i2cReleaseBus(&HW_I2C_DEV);
}

void hw_stop_i2c(void) {
	i2cAcquireBus(&HW_I2C_DEV);

	if (i2c_running) {
		palSetPadMode(HW_I2C_SCL_PORT, HW_I2C_SCL_PIN, PAL_MODE_INPUT);
		palSetPadMode(HW_I2C_SDA_PORT, HW_I2C_SDA_PIN, PAL_MODE_INPUT);

		i2cStop(&HW_I2C_DEV);
		i2c_running = false;

	}

	i2cReleaseBus(&HW_I2C_DEV);
}

/**
 * Try to restore the i2c bus
 */
void hw_try_restore_i2c(void) {
	if (i2c_running) {
		i2cAcquireBus(&HW_I2C_DEV);

		palSetPadMode(HW_I2C_SCL_PORT, HW_I2C_SCL_PIN,
				PAL_STM32_OTYPE_OPENDRAIN |
				PAL_STM32_OSPEED_MID1 |
				PAL_STM32_PUDR_PULLUP);

		palSetPadMode(HW_I2C_SDA_PORT, HW_I2C_SDA_PIN,
				PAL_STM32_OTYPE_OPENDRAIN |
				PAL_STM32_OSPEED_MID1 |
				PAL_STM32_PUDR_PULLUP);

		palSetPad(HW_I2C_SCL_PORT, HW_I2C_SCL_PIN);
		palSetPad(HW_I2C_SDA_PORT, HW_I2C_SDA_PIN);

		chThdSleep(1);

		for(int i = 0;i < 16;i++) {
			palClearPad(HW_I2C_SCL_PORT, HW_I2C_SCL_PIN);
			chThdSleep(1);
			palSetPad(HW_I2C_SCL_PORT, HW_I2C_SCL_PIN);
			chThdSleep(1);
		}

		// Generate start then stop condition
		palClearPad(HW_I2C_SDA_PORT, HW_I2C_SDA_PIN);
		chThdSleep(1);
		palClearPad(HW_I2C_SCL_PORT, HW_I2C_SCL_PIN);
		chThdSleep(1);
		palSetPad(HW_I2C_SCL_PORT, HW_I2C_SCL_PIN);
		chThdSleep(1);
		palSetPad(HW_I2C_SDA_PORT, HW_I2C_SDA_PIN);

		palSetPadMode(HW_I2C_SCL_PORT, HW_I2C_SCL_PIN,
				PAL_MODE_ALTERNATE(HW_I2C_GPIO_AF) |
				PAL_STM32_OTYPE_OPENDRAIN |
				PAL_STM32_OSPEED_MID1 |
				PAL_STM32_PUDR_PULLUP);

		palSetPadMode(HW_I2C_SDA_PORT, HW_I2C_SDA_PIN,
				PAL_MODE_ALTERNATE(HW_I2C_GPIO_AF) |
				PAL_STM32_OTYPE_OPENDRAIN |
				PAL_STM32_OSPEED_MID1 |
				PAL_STM32_PUDR_PULLUP);

		HW_I2C_DEV.state = I2C_STOP;
		i2cStart(&HW_I2C_DEV, &i2cfg);

		i2cReleaseBus(&HW_I2C_DEV);
	}
}

static THD_FUNCTION(mux_thread, arg) {
	(void)arg;

	chRegSetThreadName("adc_mux");

	palSetPadMode(ADC_SW_1_PORT, ADC_SW_1_PIN ,
			PAL_MODE_OUTPUT_PUSHPULL |
			PAL_STM32_OSPEED_HIGHEST);
	palSetPadMode(ADC_SW_2_PORT, ADC_SW_2_PIN,
			PAL_MODE_OUTPUT_PUSHPULL |
			PAL_STM32_OSPEED_HIGHEST);
	palSetPadMode(ADC_SW_3_PORT, ADC_SW_3_PIN ,
			PAL_MODE_OUTPUT_PUSHPULL |
			PAL_STM32_OSPEED_HIGHEST);

#define T_SAMP_US		500

	for (;;) {
		ADCMUX_MOT_TEMP();
		// Wait longer on this one as some temperature sensors, e.g. the PT1000 change very little
		// and the voltage divider gives us bad resolution for it.
		chThdSleepMilliseconds(5);
		ADC_Value[ADC_IND_TEMP_MOTOR] = ADC_Value[ADC_IND_ADC_MUX];

		ADCMUX_12V_SENSE_V();
		chThdSleepMicroseconds(T_SAMP_US);
		ADC_Value[ADC_IND_12V_SENSE_V] = ADC_Value[ADC_IND_ADC_MUX];

		ADCMUX_MOS_TEMP1();
		chThdSleepMicroseconds(T_SAMP_US);
		ADC_Value[ADC_IND_TEMP_MOS] = ADC_Value[ADC_IND_ADC_MUX];

		ADCMUX_MOS_TEMP2();
		chThdSleepMicroseconds(T_SAMP_US);
		ADC_Value[ADC_IND_TEMP_MOS_2] = ADC_Value[ADC_IND_ADC_MUX];

		ADCMUX_12V_SENSE_I();
		chThdSleepMicroseconds(T_SAMP_US);
		ADC_Value[ADC_IND_12V_SENSE_I] = ADC_Value[ADC_IND_ADC_MUX];

		ADCMUX_5V_SENSE_V();
		chThdSleepMicroseconds(T_SAMP_US);
		ADC_Value[ADC_IND_5V_SENSE_V] = ADC_Value[ADC_IND_ADC_MUX];

		ADCMUX_MOS_TEMP3();
		chThdSleepMicroseconds(T_SAMP_US);
		ADC_Value[ADC_IND_TEMP_MOS_3] = ADC_Value[ADC_IND_ADC_MUX];

		ADCMUX_TEMP_DCDC();
		chThdSleepMicroseconds(T_SAMP_US);
		ADC_Value[ADC_IND_TEMP_DCDC] = ADC_Value[ADC_IND_ADC_MUX];

		// Config check
		mc_configuration *mcconf = (mc_configuration*)mc_interface_get_configuration();

		if (mcconf->motor_type == MOTOR_TYPE_FOC &&
				mcconf->foc_sensor_mode == FOC_SENSOR_MODE_HALL) {

			// In hall sensor mode we use the ADC pins on the comm-port as additional
			// pull-ups as the voltage dividers take the voltage down otherwise.
			palSetPadMode(HW_ADC_EXT3_GPIO, HW_ADC_EXT3_PIN, PAL_MODE_OUTPUT_PUSHPULL);
			palSetPadMode(HW_ADC_EXT4_GPIO, HW_ADC_EXT4_PIN, PAL_MODE_OUTPUT_PUSHPULL);
			palSetPad(HW_ADC_EXT3_GPIO, HW_ADC_EXT3_PIN);
			palSetPad(HW_ADC_EXT4_GPIO, HW_ADC_EXT4_PIN);

			// Prevent the uart-pins from interfering
			palSetPadMode(HW_UART_TX_PORT, HW_UART_TX_PIN, PAL_MODE_INPUT);
			palSetPadMode(HW_UART_RX_PORT, HW_UART_RX_PIN, PAL_MODE_INPUT);
		} else if (mcconf->motor_type == MOTOR_TYPE_FOC &&
			(mcconf->foc_sensor_mode == FOC_SENSOR_MODE_ENCODER ||
			 mcconf->foc_sensor_mode == FOC_SENSOR_MODE_ENCODER_AB)) {

			// Prevent the uart-pins from interfering
			if (mcconf->m_sensor_port_mode == SENSOR_PORT_MODE_ABI ||
					mcconf->m_sensor_port_mode == SENSOR_PORT_MODE_AS5047_SPI ||
					mcconf->m_sensor_port_mode == SENSOR_PORT_MODE_PWM_ABI ||
					mcconf->m_sensor_port_mode == SENSOR_PORT_MODE_PWM_ABI_INVERTED ||
					mcconf->m_sensor_port_mode == SENSOR_PORT_MODE_SINCOS) {
				palSetPadMode(HW_UART_TX_PORT, HW_UART_TX_PIN, PAL_MODE_INPUT);
				palSetPadMode(HW_UART_RX_PORT, HW_UART_RX_PIN, PAL_MODE_INPUT);
			}

			// Ensure that the sin/cos pins are in ADC mode
			if (mcconf->m_sensor_port_mode == SENSOR_PORT_MODE_SINCOS) {
				palSetPadMode(HW_ADC_EXT3_GPIO, HW_ADC_EXT3_PIN, PAL_MODE_INPUT_ANALOG);
				palSetPadMode(HW_ADC_EXT4_GPIO, HW_ADC_EXT4_PIN, PAL_MODE_INPUT_ANALOG);
			}
		}
	}
}

bool hw_sample_shutdown_button(void) {
	return ADC_VOLTS(ADC_IND_SHUTDOWN) > 0.8;
}

float hw100_400_get_temp(void) {
	float t1 = (1.0 / ((logf(NTC_RES(ADC_Value[ADC_IND_TEMP_MOS]) / 10000.0) / 3380.0) + (1.0 / 298.15)) - 273.15);
	float t2 = (1.0 / ((logf(NTC_RES(ADC_Value[ADC_IND_TEMP_MOS_2]) / 10000.0) / 3380.0) + (1.0 / 298.15)) - 273.15);
	float t3 = (1.0 / ((logf(NTC_RES(ADC_Value[ADC_IND_TEMP_MOS_3]) / 10000.0) / 3380.0) + (1.0 / 298.15)) - 273.15);
	float res = 0.0;

	if (t1 > t2 && t1 > t3) {
		res = t1;
	} else if (t2 > t1 && t2 > t3) {
		res = t2;
	} else {
		res = t3;
	}

	return res;
}
