poommyroboticcamera-netizen/ESC-FOC-Drive-V02/(commit log)

2026-09-19 Add ESC FOC drive source, hardware files, and documentation
    [BOM_BLDCv02.xlsx, PickAndPlace_BLDCV02.xlsx, overvoltage_test_v1.ods, overvoltage_test_v2.ods, partitions.csv, pi_stm32.cfg, stm32-bv_openocd.cfg, stm32f407g.cfg]
2026-09-19 Polish repository presentation with real board imagery
2026-10-16 Add Arduino six-step releases and SAT motor pilot app
2026-10-20 Publish SAT motor pilot as HTTPS web app
2026-10-23 Place README language switch beside status badges (#2)
2026-10-23 Link language badges to repository landing pages (#3)
2026-10-23 Show Thai README on Thai landing branch (#4)
2026-10-27 Add v34 low-side current telemetry and SAT motor pilot 1.1.0
2026-10-27 Document INA181 output capacitor erratum and zero-calibration failure
2026-10-27 Clarify current-sense rework in app release notes
